danyliuk361/BatchTherm/docs/figures/pulseview-gpio.png

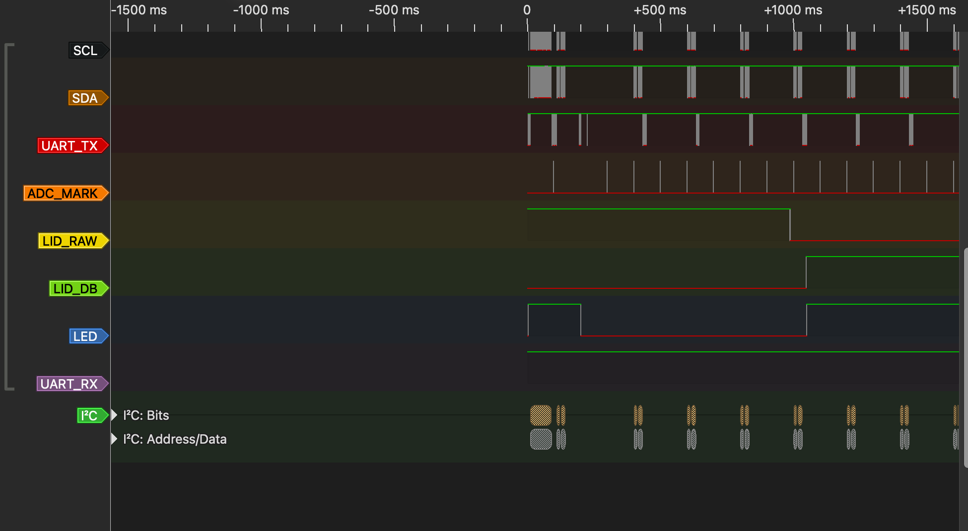
docs/figures/pulseview-gpio.png
