danyliuk361/BatchTherm/docs/figures/pulseview-i2c.png

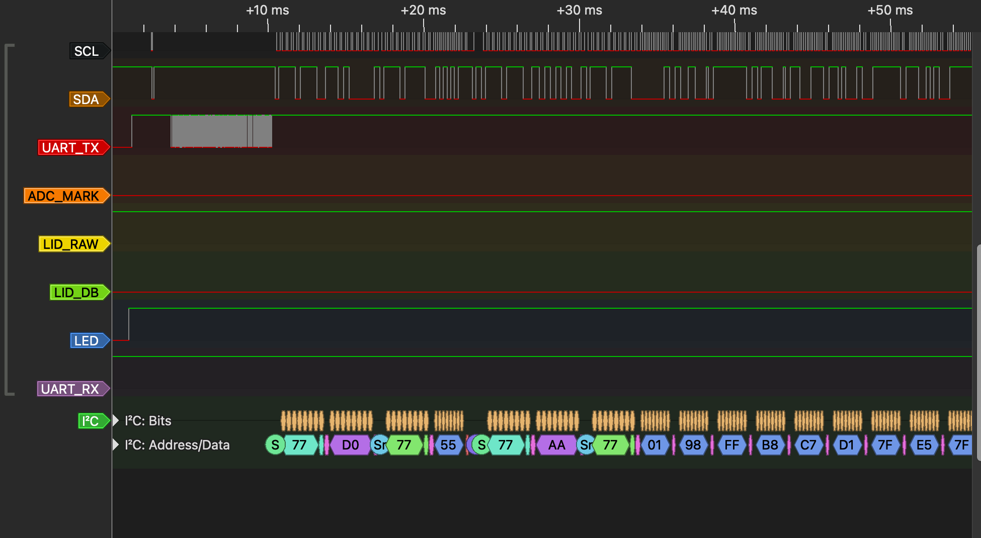
docs/figures/pulseview-i2c.png
