danyliuk361/BatchTherm/docs/lab-plan.md

# Етапи BatchTherm

1. ЛР1: вимоги, первинні документи, стартовий HAL, Docker/reproducibility, UART/LED, реальні скриншоти та PDF. Драйверів сенсорів тут немає.
2. ЛР2: pinout, GPIO/I²C/ADC, self-test, валідність, медіана, debounce, одночасний стенд, VCD і незалежне декодування, помилки/відновлення, host coverage/CI. Окремий bring-up сховища — підготовка ЛР3.
3. ЛР3: автомат партій, CLI, постійний журнал, TIM3/GPIO виміри, S1/S2/S3, година MCU часу, power-loss, реєстр обмежень і baseline.
4. ЛР4: FreeRTOS ARM_CM0, збережені FR/CLI, обидві версії в один день і шість RTOS експериментів. Не реалізовано на цьому етапі.
5. ЛР5–6: чекати оригінальні завдання.

Детальні критерії — у PRD. Сценарій відео не є записом студента. PR/доступ викладача і фактичний запис перевіряються окремо від технічної частини.
