danyliuk361/BatchTherm/docs/captures/lab2/timing-summary.txt

{
  "scl_period_us": {
    "n": 1192,
    "min": 235.5,
    "avg": 312.87242030201344,
    "max": 356.75
  },
  "period_ms": {
    "UART_TX": {
      "n": 6570,
      "min": 0.017375,
      "avg": 0.4633354490106545,
      "max": 208.045
    },
    "SDA": {
      "n": 400,
      "min": 0.46175,
      "avg": 7.569512125,
      "max": 259.1506
    },
    "SCL": {
      "n": 1390,
      "min": 0.2355,
      "avg": 2.178276870503597,
      "max": 259.3761
    },
    "ADC_MARK": {
      "n": 29,
      "min": 99.98115,
      "avg": 103.44965603448276,
      "max": 200.1196
    },
    "LID_RAW": {
      "n": 118,
      "min": 0.0012,
      "avg": 10.190961016949153,
      "max": 1197.718725
    },
    "LED": {
      "n": 1,
      "min": 1046.711275,
      "avg": 1046.711275,
      "max": 1046.711275
    }
  },
  "high_width_us": {
    "UART_TX": {
      "n": 6570,
      "min": 8.675,
      "avg": 447.52433789954335,
      "max": 208027.6
    },
    "SDA": {
      "n": 400,
      "min": 119.25,
      "avg": 7085.7793125,
      "max": 258916.1
    },
    "SCL": {
      "n": 1390,
      "min": 115.75,
      "avg": 1971.0037230215828,
      "max": 259144.1
    },
    "ADC_MARK": {
      "n": 30,
      "min": 1233.975,
      "avg": 1233.9966666666667,
      "max": 1234.5
    },
    "LED": {
      "n": 2,
      "min": 197706.65,
      "avg": 698953.7,
      "max": 1200200.75
    },
    "LID_RAW": {
      "n": 118,
      "min": 0.2,
      "avg": 20.55826271186441,
      "max": 110.375
    },
    "LID_DB": {
      "n": 1,
      "min": 1200197.8,
      "avg": 1200197.8,
      "max": 1200197.8
    }
  }
}
I2C frames 49
