danyliuk361/BatchTherm/docs/lab3-report.md

# Матеріали звіту ЛР3: BatchTherm

Данилюк Вадим Ігорович, ІО-36. Вимірювання відтворюються за [базовою лінією](baseline-lab4.md), [задачами](lab3-tasks.md) і [реєстром обмежень](limitations.md). Ідентичність прошивки: `docs/evidence/lab3/identity.json`. Сирі UART і таблиці — `docs/metrics/lab3`, VCD — `docs/captures/lab3`.

[Звіт ЛР3 (PDF)](../Reports/ІО-36_Вадим_Данилюк_Лабораторна_робота_3.pdf)
