danyliuk361/BatchTherm/docs/limitations.md

# Реєстр обмежень BatchTherm (ЛР3)

Nucleo-C031C6, Wokwi 4.1.0, час MCU. Докази та команди — у [базовій лінії](baseline-lab4.md). Гіпотези призначені для ЛР4.

| ID | Доказ і причина | Без ОС | Механізм ОС і ціна | Гіпотеза для ЛР4 |
|---|---|---|---|---|
| О1 | FR-05: 11819 пропусків 5-мс релізів у S3 проти 1629 у S1; 36 реакцій, максимум 89,466 мс. I²C, UART TX і SD затримують наступний прохід. | EXTI і відкладене підтвердження 25 мс. | Задача кришки з вищим пріоритетом; потрібен її стек і доставка події ISR → задача. | 0 пропусків релізів і максимум реакції ≤50 мс. |
| О2 | FR-07: 30 прийнятих abort, максимум 1734,645 мс проти 150 мс. ACK чекає стійкого запису; картка обробляє один сектор за раз. | Окремий носій для термінального стану або погоджена зміна семантики ACK. | Пріоритет дописування через одну задачу SD; затримка носія лишається, а mutex може дати інверсію. | Максимум зменшиться ≥20%, але буде >150 мс за того самого контракту й носія. |
| О3 | FR-07: S3 841 з 841 status отримали ACK, VCD максимум 64,910 мс. На 50 команд/с максимум 363,377 мс і 50 втрачених байтів. RX ISR швидкий, але парсинг і TX ділять цикл з I²C та SD. | UART DMA/IT TX, бюджет виводу і ліміти швидкості хоста. | Пріоритетна задача RX, пам'ять черги і політика переповнення. | 0 втрат за 20 команд/с і status ≤150 мс у змішаному S3. |
| О4 | FR-01/05: BMP у S3 до 32,573 мс. SDA звільнено на 933,274 мс, спільний кадр на 1126 мс після наступного релізу. Conversion і GPIO I²C синхронні. | Розділити запит і читання; обмежений повтор раніше чергового релізу. | Блокування задачі сенсора; стек, черга, контроль віку кадру. | Джитер NTC ≤10 мс, справні кадри BMP не старші 600 мс. |
| О5 | FR-06: сканування 512 секторів завершилось на 262,517 с від boot, після чого start відхилено без стирання. | Два контрольні блоки з CRC, fallback на scan. | Фонове сканування; доступ до SD лишається серіалізованим. | Перший справний кадр ≤1 с; scan без зміни формату не швидше за базу більш ніж на 15%. |
| О6 | Один резерв стеку 2048 Б, вимір 812 Б у S3; heap 0; FLASH 27616 з 32768 Б і RAM 5024 з 12288 Б. | Зберегти один стек. | Стеки, TCB, черги, tick, context switch; перевірити overflow й malloc-failure. | Додаткова RAM для ядра й об’єктів ≤4096 Б; вміститися у 32/12 KiB. |

Фізичний brownout microSD не моделюється. Stop при високому PA10, повторний запуск з образом і тест обривів сектора перевіряють логічний контракт. Стан живлення або кеша фізичної карти треба виміряти на платі.
