danyliuk361/BatchTherm/docs/captures/lab2/spi-timing-summary.txt

{
  "scl_period_us": {
    "n": 3576,
    "min": 235.35,
    "avg": 313.41768036912754,
    "max": 397.125
  },
  "period_ms": {
    "UART_TX": {
      "n": 20224,
      "min": 0.017375,
      "avg": 0.4669690256625791,
      "max": 838.8022
    },
    "SDA": {
      "n": 1208,
      "min": 0.46175,
      "avg": 7.957399151490066,
      "max": 861.81655
    },
    "SCL": {
      "n": 4177,
      "min": 0.23535,
      "avg": 2.3016054345223846,
      "max": 862.04205
    },
    "SCK": {
      "n": 13367,
      "min": 0.095525,
      "avg": 0.5175209396274407,
      "max": 3257.588125
    },
    "MISO": {
      "n": 2075,
      "min": 0.19135,
      "avg": 3.33332621686747,
      "max": 3265.229975
    },
    "MOSI": {
      "n": 1063,
      "min": 0.1916,
      "avg": 6.128409948259643,
      "max": 3263.87025
    },
    "CS": {
      "n": 8,
      "min": 7.74735,
      "avg": 864.630484375,
      "max": 3678.8961
    },
    "ADC_MARK": {
      "n": 95,
      "min": 1.272125,
      "avg": 99.99901157894737,
      "max": 892.67175
    }
  },
  "high_width_us": {
    "UART_TX": {
      "n": 20224,
      "min": 8.675,
      "avg": 451.17181566455696,
      "max": 838793.5
    },
    "SDA": {
      "n": 1209,
      "min": 119.25,
      "avg": 7469.895864350703,
      "max": 861582.05
    },
    "SCL": {
      "n": 4177,
      "min": 114.825,
      "avg": 2093.739819248264,
      "max": 861810.05
    },
    "ADC_MARK": {
      "n": 96,
      "min": 1232.0,
      "avg": 1233.9221354166666,
      "max": 1236.475
    },
    "SCK": {
      "n": 13368,
      "min": 48.025,
      "avg": 48.37045930580491,
      "max": 50.75
    },
    "MISO": {
      "n": 2075,
      "min": 95.6,
      "avg": 3129.8181325301207,
      "max": 3264456.725
    },
    "CS": {
      "n": 8,
      "min": 778.725,
      "avg": 704956.046875,
      "max": 3258260.6
    },
    "MOSI": {
      "n": 1063,
      "min": 95.6,
      "avg": 5911.486923800565,
      "max": 3263771.75
    }
  }
}
I2C frames 150
