danyliuk361/BatchTherm/docs/figures/lab3/clock-board.png

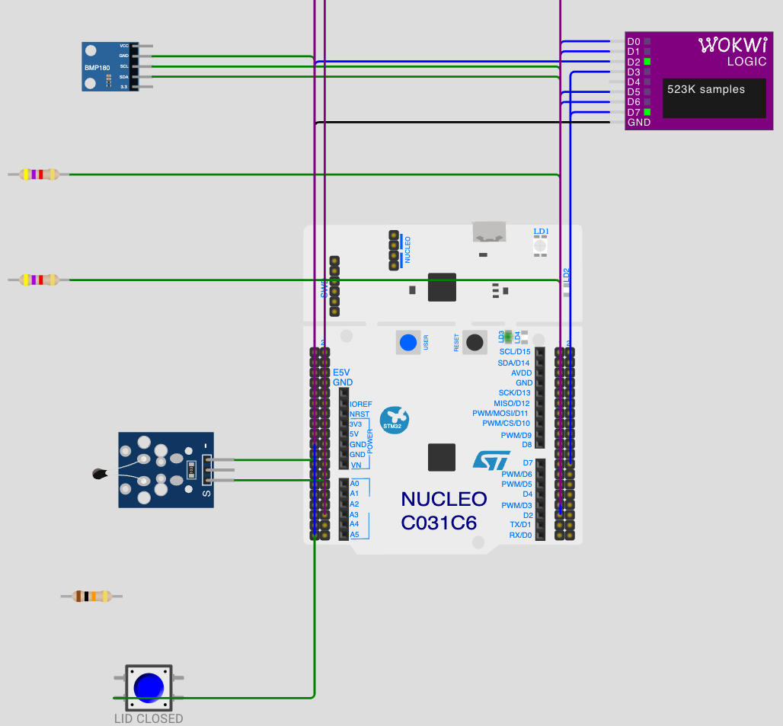
docs/figures/lab3/clock-board.png
