danyliuk361/BatchTherm/docs/figures/lab3/loop.png

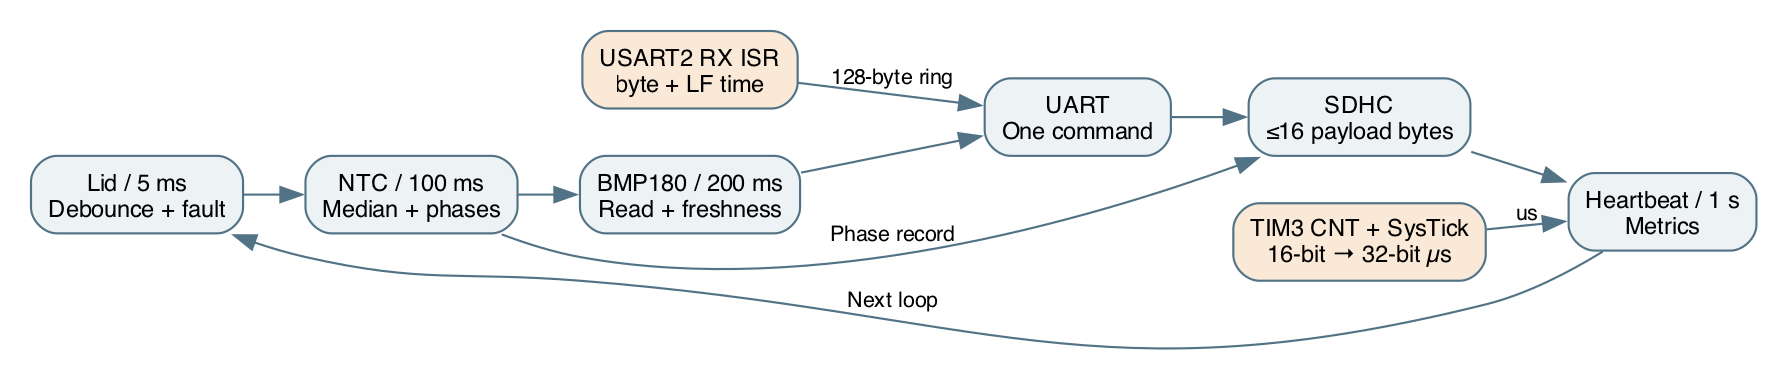
docs/figures/lab3/loop.png
