danyliuk361/BatchTherm/docs/metrics/lab2/functional-final/sample-60.png

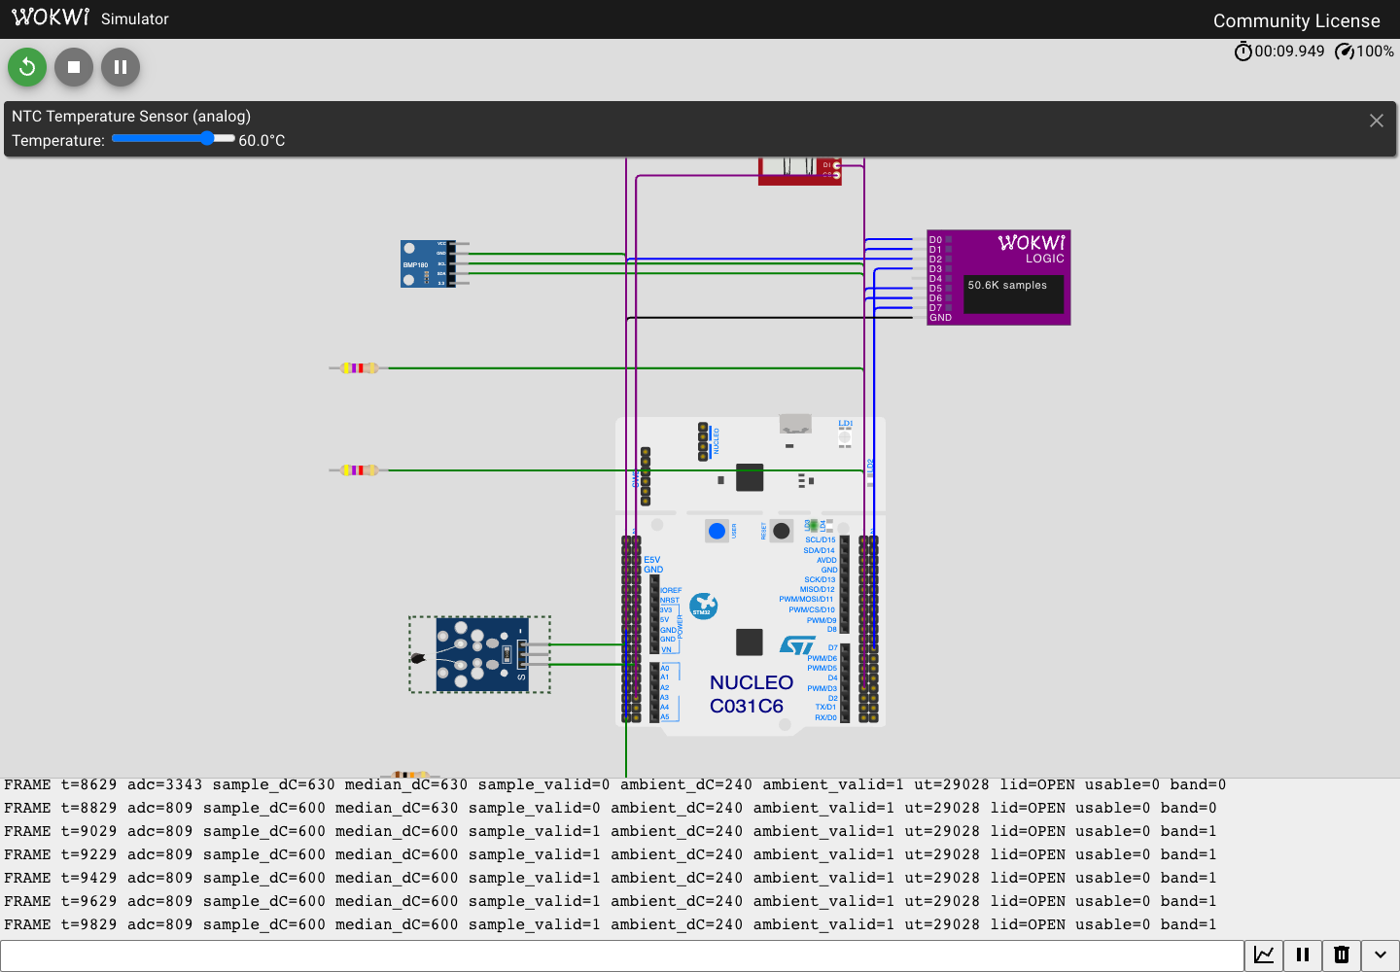
docs/metrics/lab2/functional-final/sample-60.png
