danyliuk361/BatchTherm/docs/metrics/lab2/functional-final/wokwi-full.png

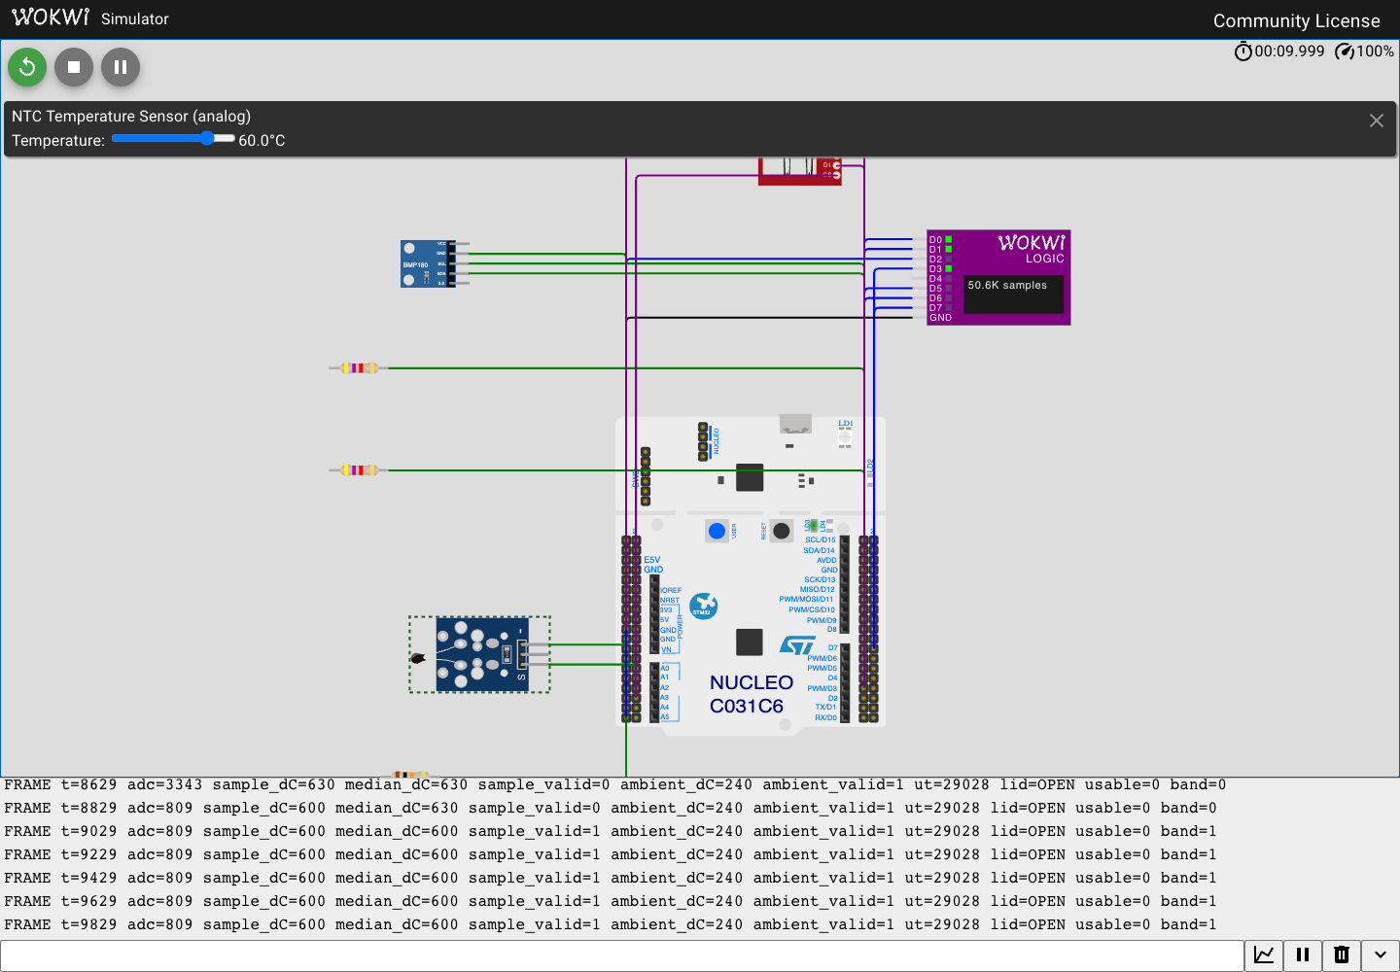
docs/metrics/lab2/functional-final/wokwi-full.png
