danyliuk361/BatchTherm/docs/metrics/lab2/i2c-diagnostic/wokwi-full.png

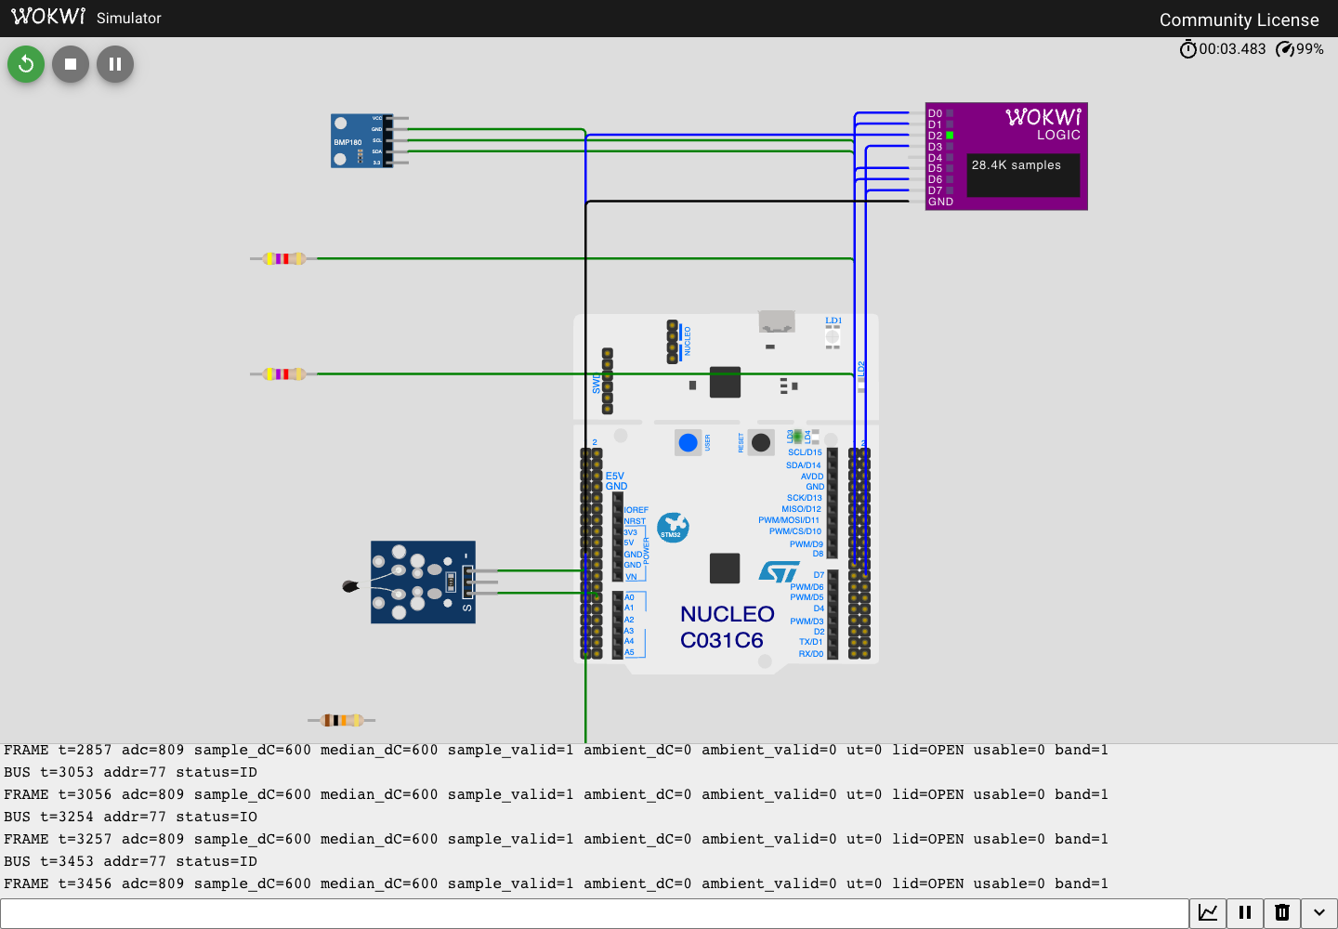
docs/metrics/lab2/i2c-diagnostic/wokwi-full.png
