danyliuk361/BatchTherm/docs/metrics/lab2/integration-final/wokwi-full.png

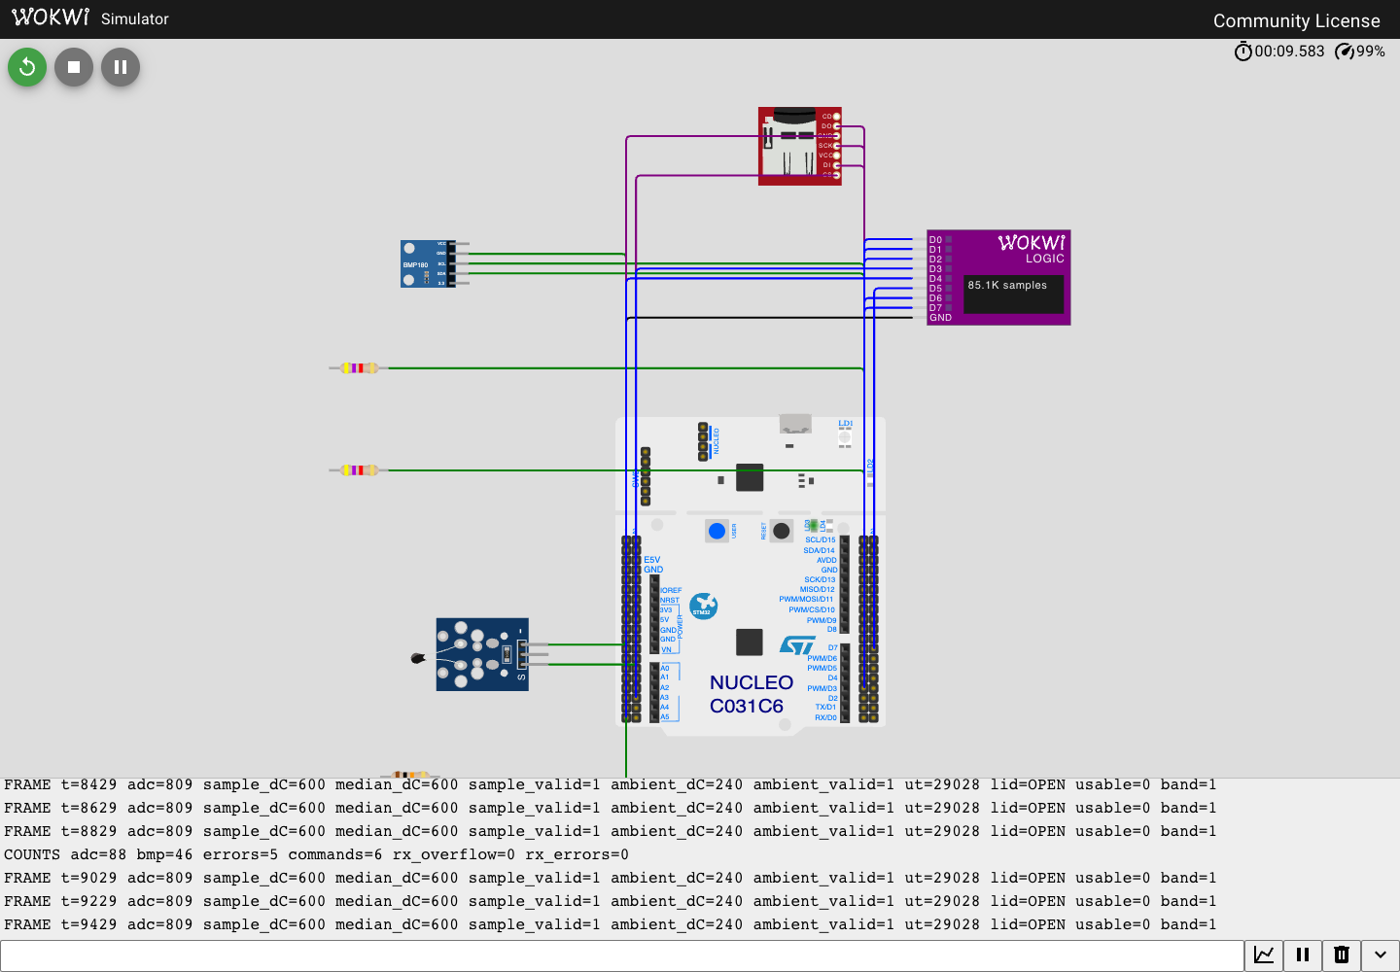
docs/metrics/lab2/integration-final/wokwi-full.png
