danyliuk361/BatchTherm/docs/metrics/lab2/integration-sd-first/wokwi-full.png

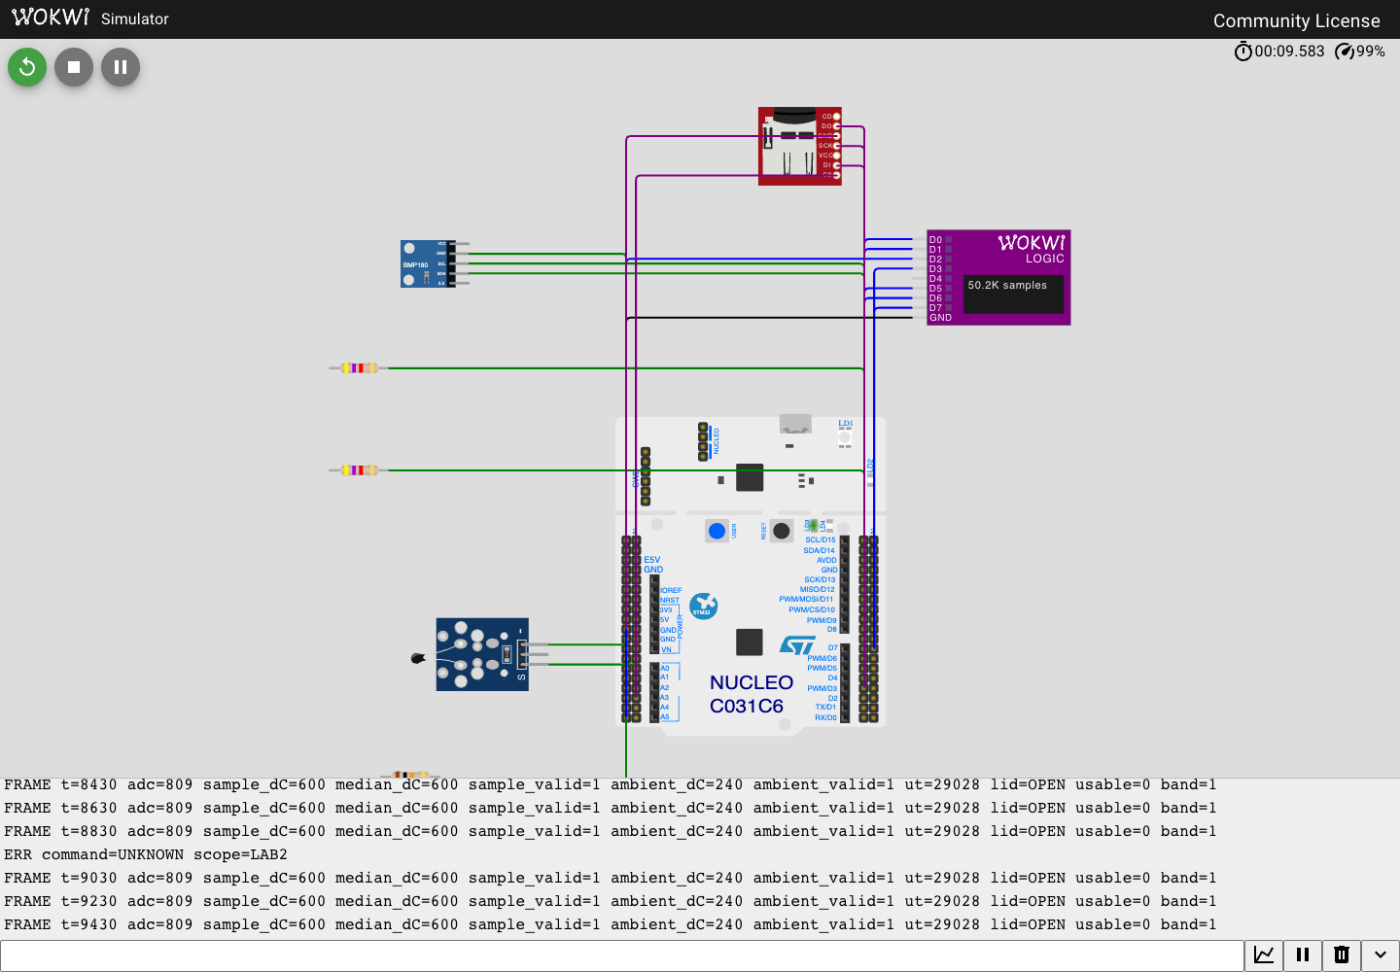
docs/metrics/lab2/integration-sd-first/wokwi-full.png
