danyliuk361/BatchTherm/docs/metrics/lab2/integration-uart-ring/wokwi-full.png

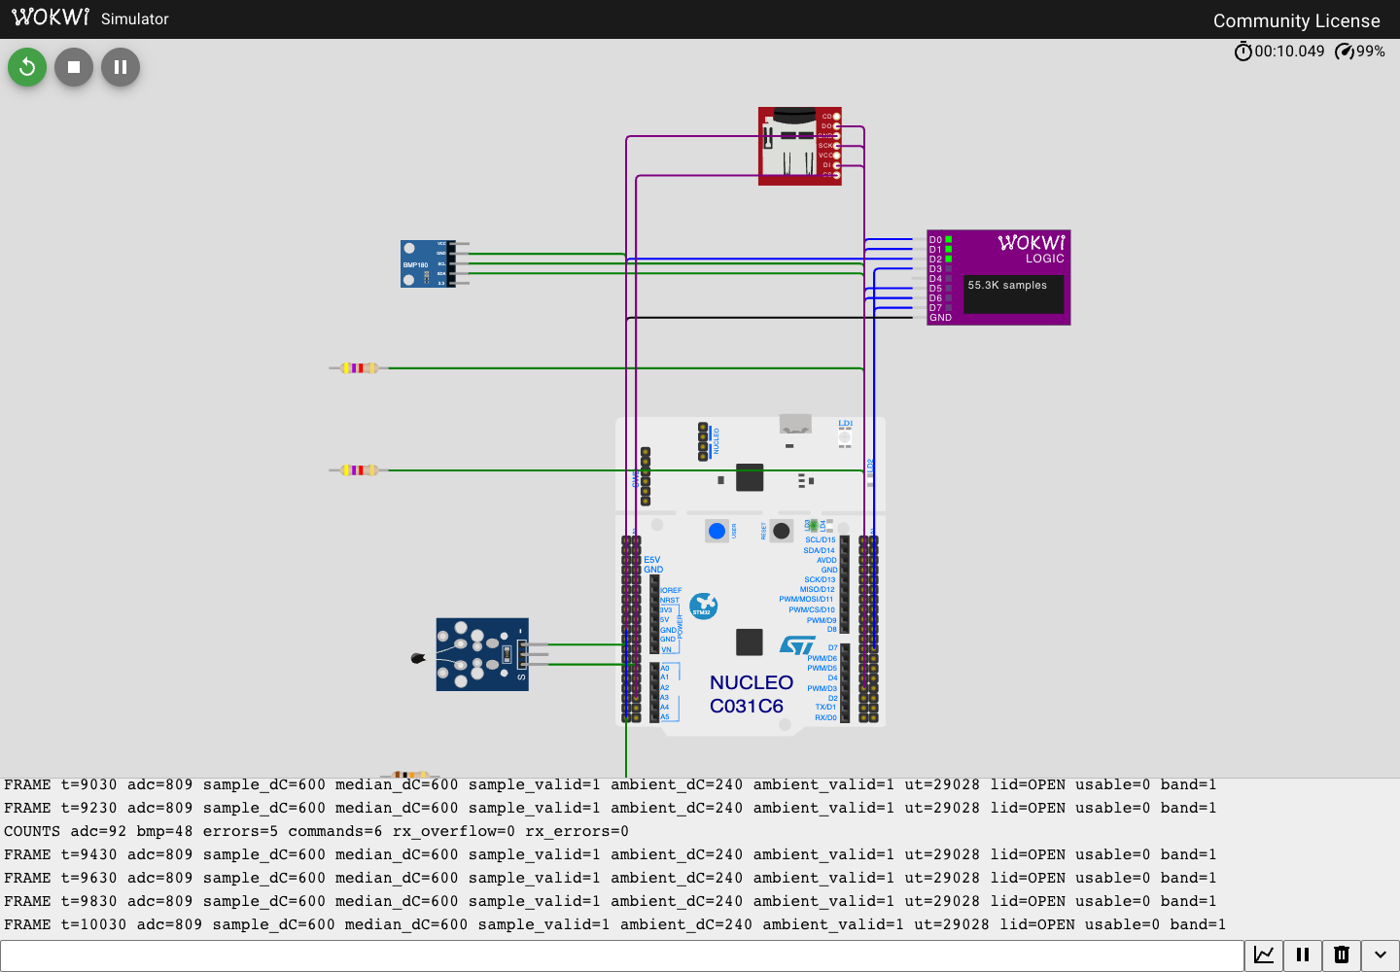
docs/metrics/lab2/integration-uart-ring/wokwi-full.png
