danyliuk361/BatchTherm/docs/metrics/lab2/lid-controls-probe/controls.png

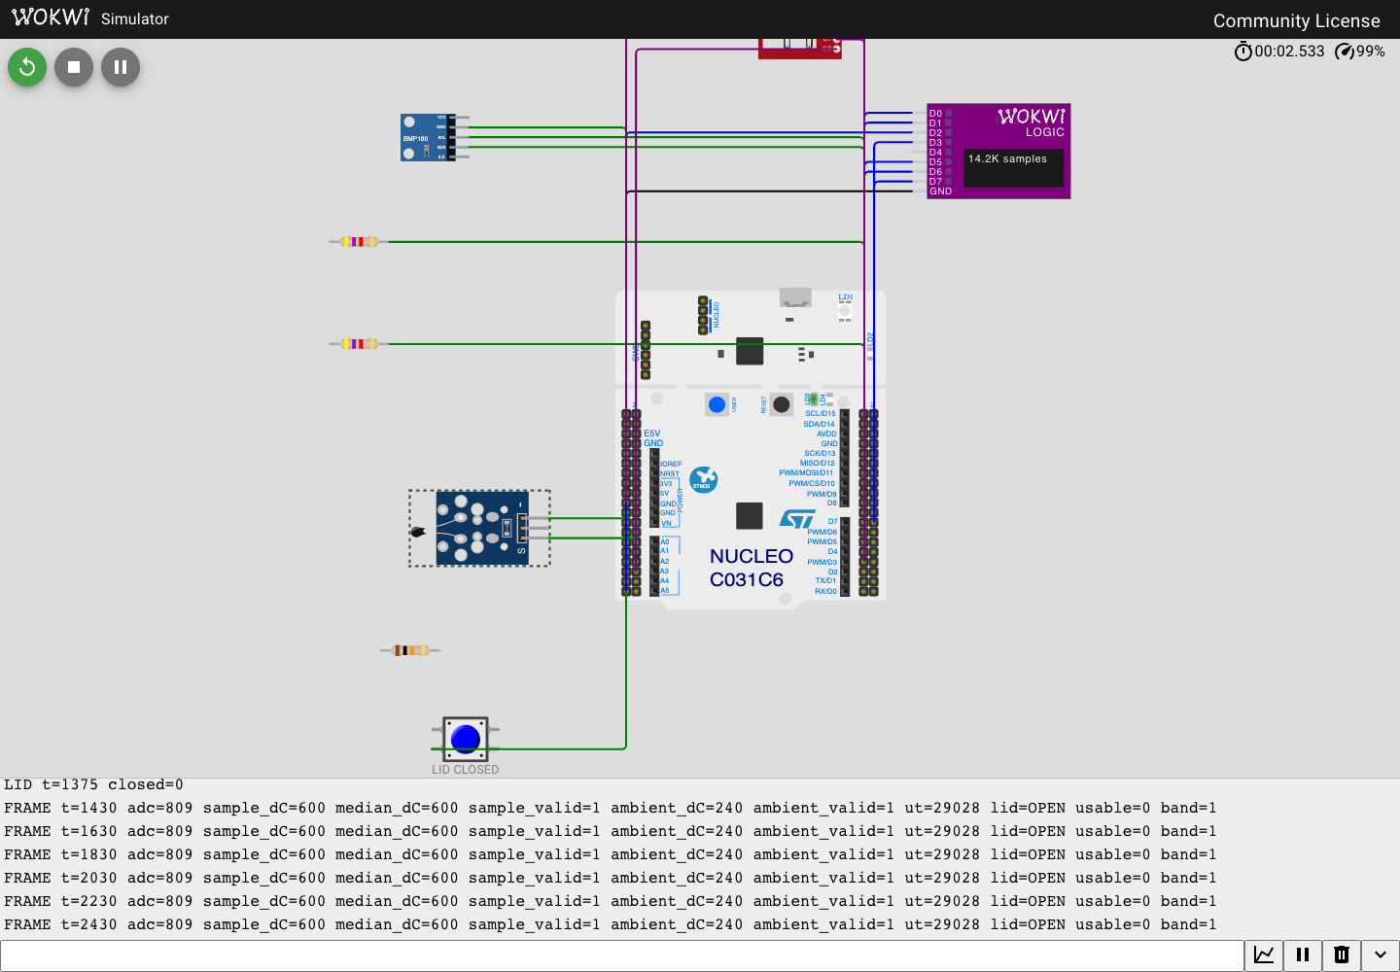
docs/metrics/lab2/lid-controls-probe/controls.png
