danyliuk361/BatchTherm/docs/metrics/lab2/temperature-controls-probe/ntc-settings.png

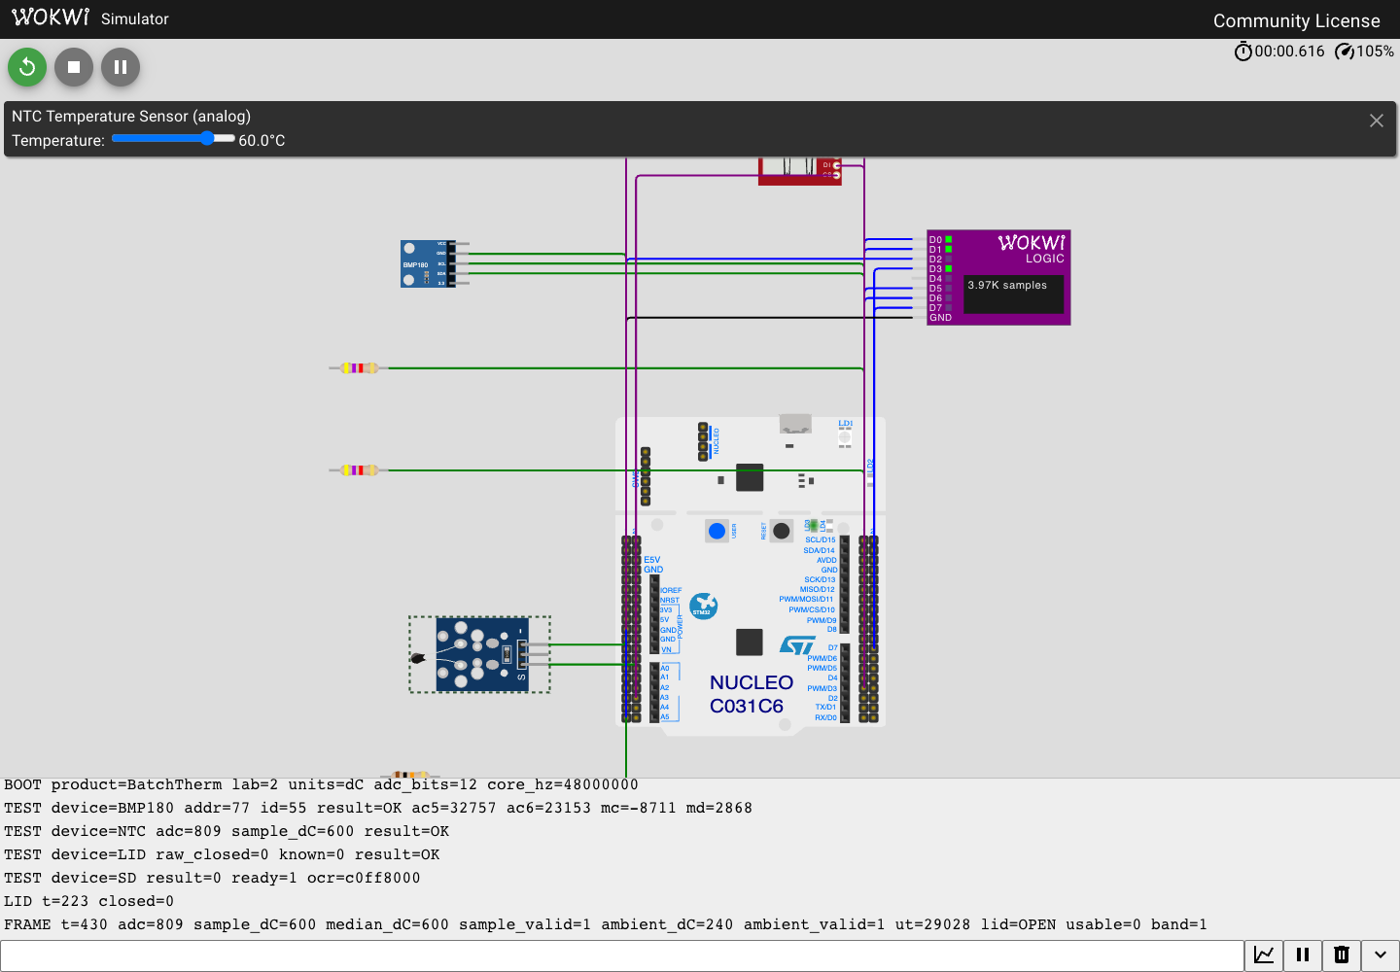
docs/metrics/lab2/temperature-controls-probe/ntc-settings.png
