danyliuk361/BatchTherm/docs/metrics/lab2/visual-final/wokwi-full.png

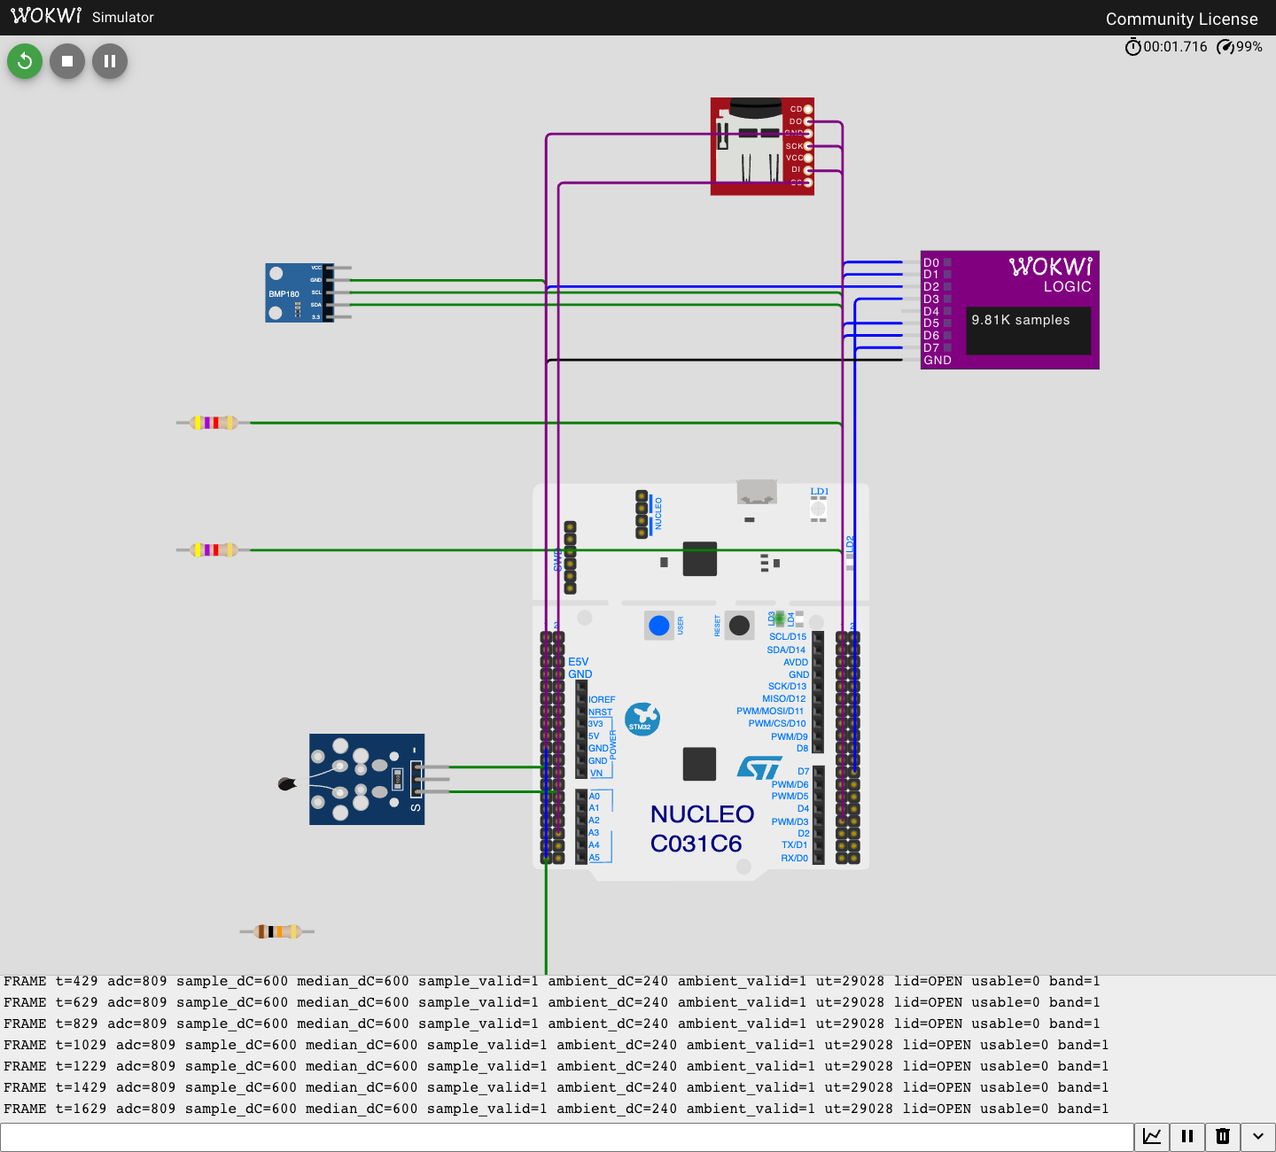
docs/metrics/lab2/visual-final/wokwi-full.png
