danyliuk361/BatchTherm/docs/figures/lab1-build-crop.png

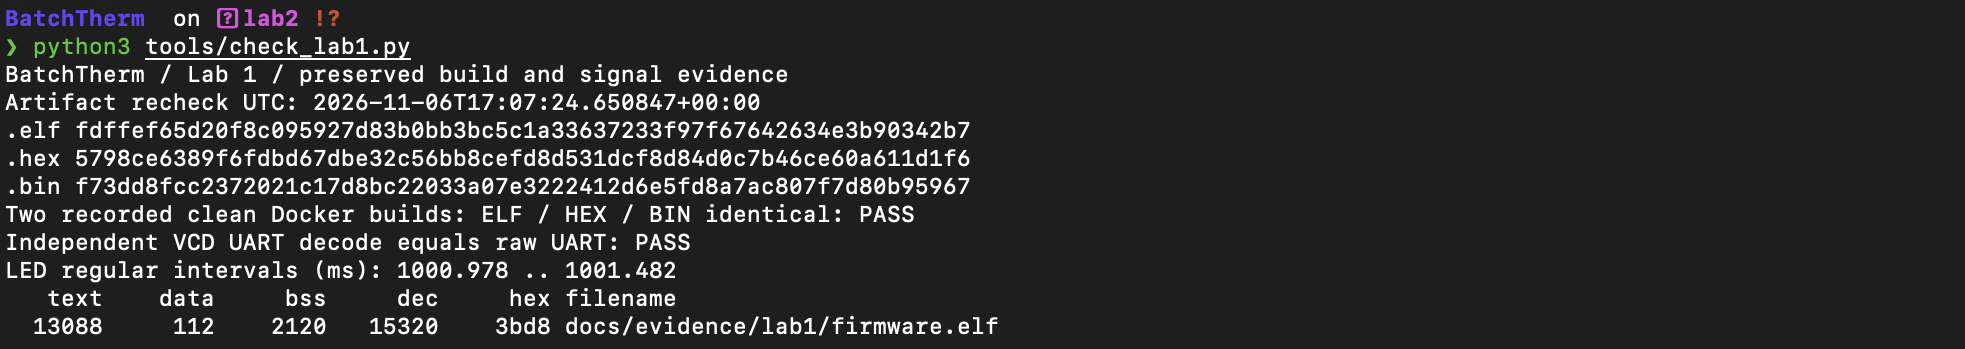
docs/figures/lab1-build-crop.png
