danyliuk361/BatchTherm/docs/figures/lab2-verification.png

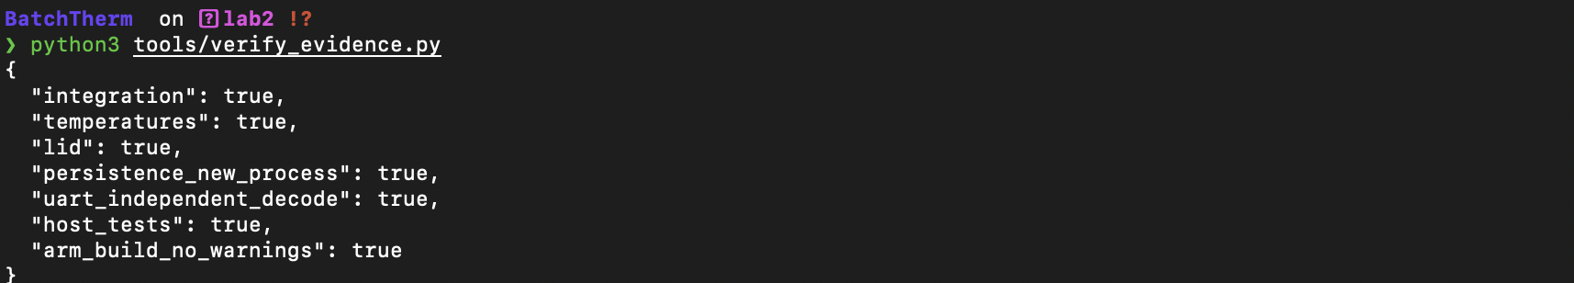
docs/figures/lab2-verification.png
