danyliuk361/BatchTherm/docs/metrics/lab2/bringup-first/wokwi-full.png

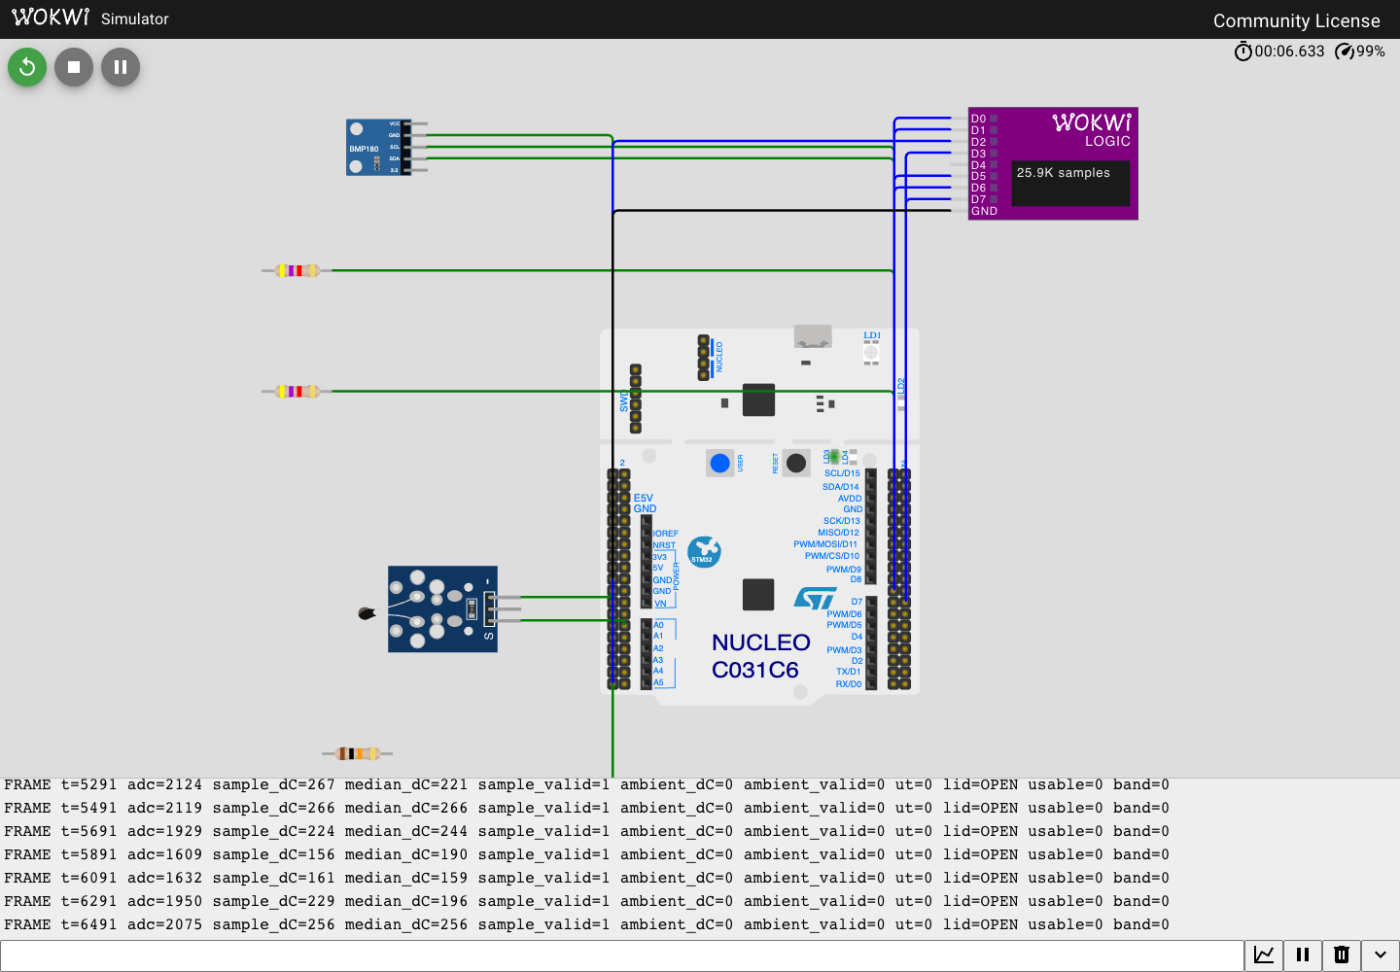
docs/metrics/lab2/bringup-first/wokwi-full.png
