danyliuk361/BatchTherm/docs/metrics/lab2/bringup-i2c-release/wokwi-full.png

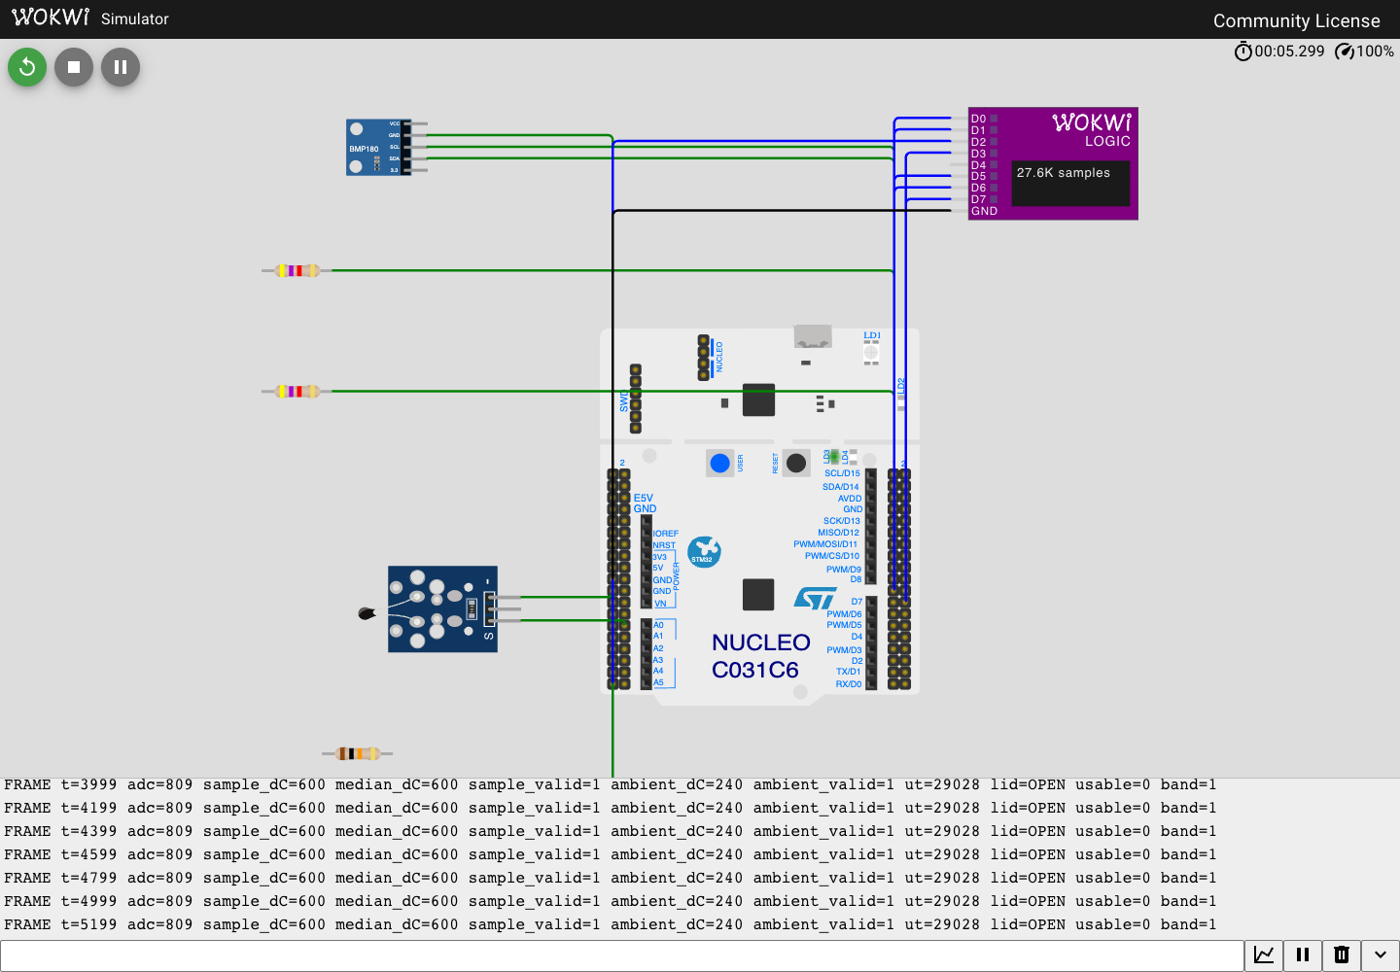
docs/metrics/lab2/bringup-i2c-release/wokwi-full.png
