danyliuk361/BatchTherm/(commit log)

2026-10-14 chore: import licensed STM32C031 HAL starter and Docker build
2026-10-18 test: verify reproducible build and Wokwi UART LED signals
2026-10-23 feat: integrate thermal sensor channels and SDHC sector bring-up
2026-10-26 test: cover bus faults thermal validity and captured sensor vectors
2026-10-30 test: preserve measured sensor bus storage and recovery evidence
2026-10-30 docs: report sensor integration measured protocols and test limits
2026-11-06 test: cover batch transitions, torn writes and timer rollover
